CamAud/Arm/README.md

# Arm

Nos rendus de séance se trouvent dans la branche "rapports"
