CamAud/Arm/rapports/séance 8_audrey.pdf

SEANCE 8

Objectif : L'objectif de cette séance était de finaliser la réception de données par Bluetooth et l’écriture réalisée par le robot.

TRAVAIL PRELIMINAIRE : Durant les vacances, j’ai essayé d’avancer au maximum. La tâche principale était de faire en sorte que le bras écrive dans un premier temps la lettre qu’il reçoit via une application Bluetooth.

Etape 1 : Créer mes fonctions de base à partir du code initial. Un travail assez simple finalement. J’ai mis le code initial dans une fonction qui prend en paramètre le point où je veux aller :

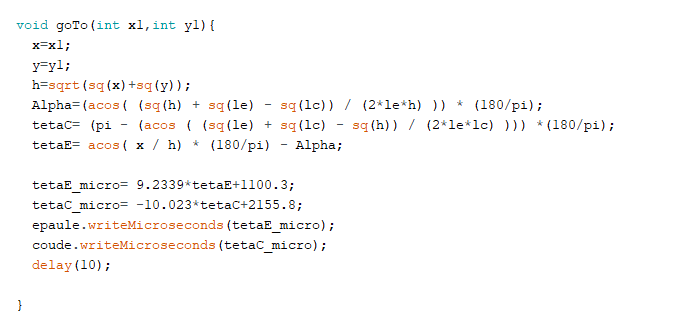
[picture p8: figure]

Pour tracer des traits verticaux et horizontaux, je n’ai donc plus qu’à appeler ces fonctions :

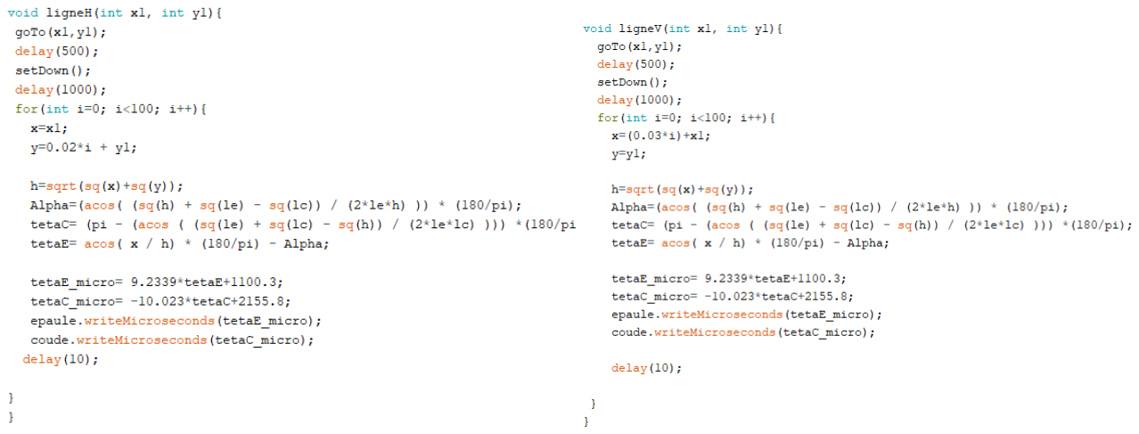
[picture p9: figure]
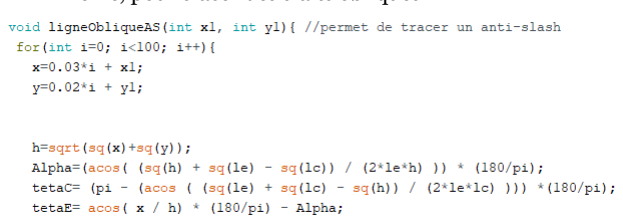
[picture p10: figure]

De même, pour tracer des traits obliques :

JONAS Audrey

Cette fonction me permet de tracer un \ mais lorsque je programme celle qui me permet de tracer un /, le bras ne trace pas du tout un trait droit. Pour cela il vaut donc mieux que j’utilise la fonction goTo.

Etape 2 : Créer une application sur MIT app inventor. Camille avait déjà essayé de créer une application au debut du projet mais elle n’était pas sure de son bon fonctionnement. De plus, elle était en vacances et je n’arrivais pas à me connecter avec son adresse mail pour avoir accès à son projet. Il a donc fallu que je regarde plusieurs tutos pour apprendre à utiliser ce « logiciel ». En m’inspirant de ce qu’elle avait fait, j’ai créé cette application :

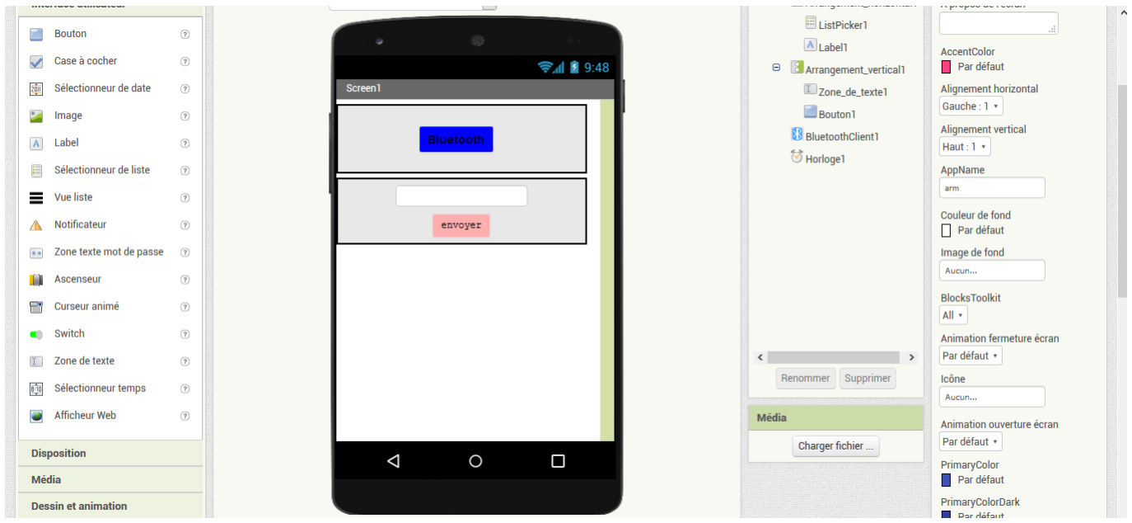
[picture p11: figure]

L’interface se présente comme ceci. Lorsque l’utilisateur appuie sur le bouton bluetooth, il peut choisir notre module bluetooth nommé « arm ». Une fois qu’il clique dessus et que son téléphone se connecte, un message « bluetooth connecté » apparait à l’écran.

Ensuite, il clique sur la barre de saisie, entre la lettre qu’il veut écrire et clique sur le bouton « envoyer ».

Comment l’application fonctionne ? J’ai du définir des « blocs » qui corresponde à différente action à effectuer :

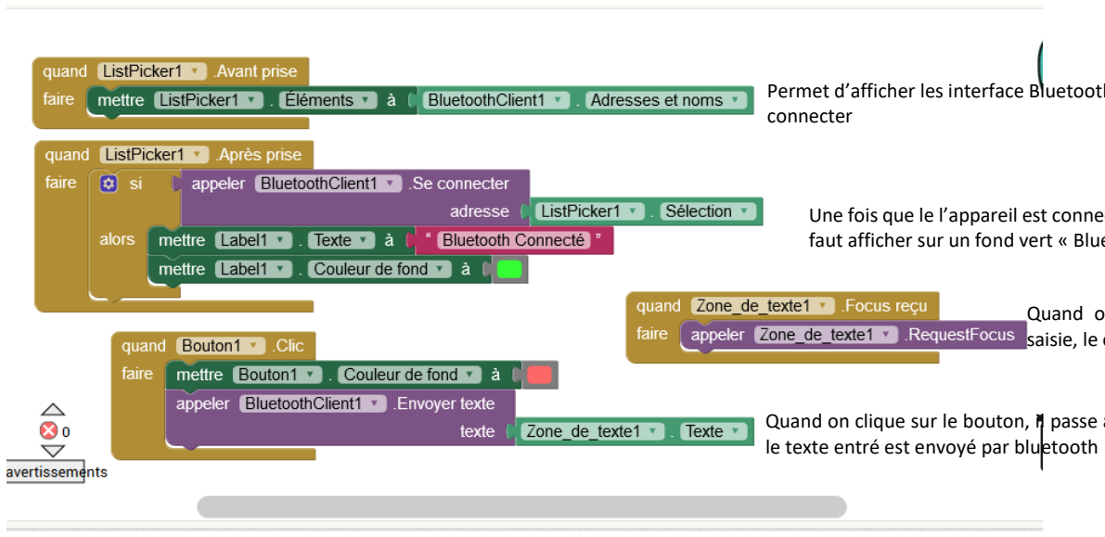
[picture p12: figure]
connecter; le texte entré est envoyé par bluetooth

Etape 3 : Configurer le bluetooth, jusque-là rien de nouveau, il a fallu ajouter :

Permet d’afficher les interface Bluetooth auxquelles on peut se

Une fois que le l’appareil est connecté au bluetooth du bras : il faut afficher sur un fond vert « Bluetooth connecté

Quand on clique sur le bouton, il passe à une couleur plus foncée et

Quand on clique sur la zone de saisie, le clavier apparait

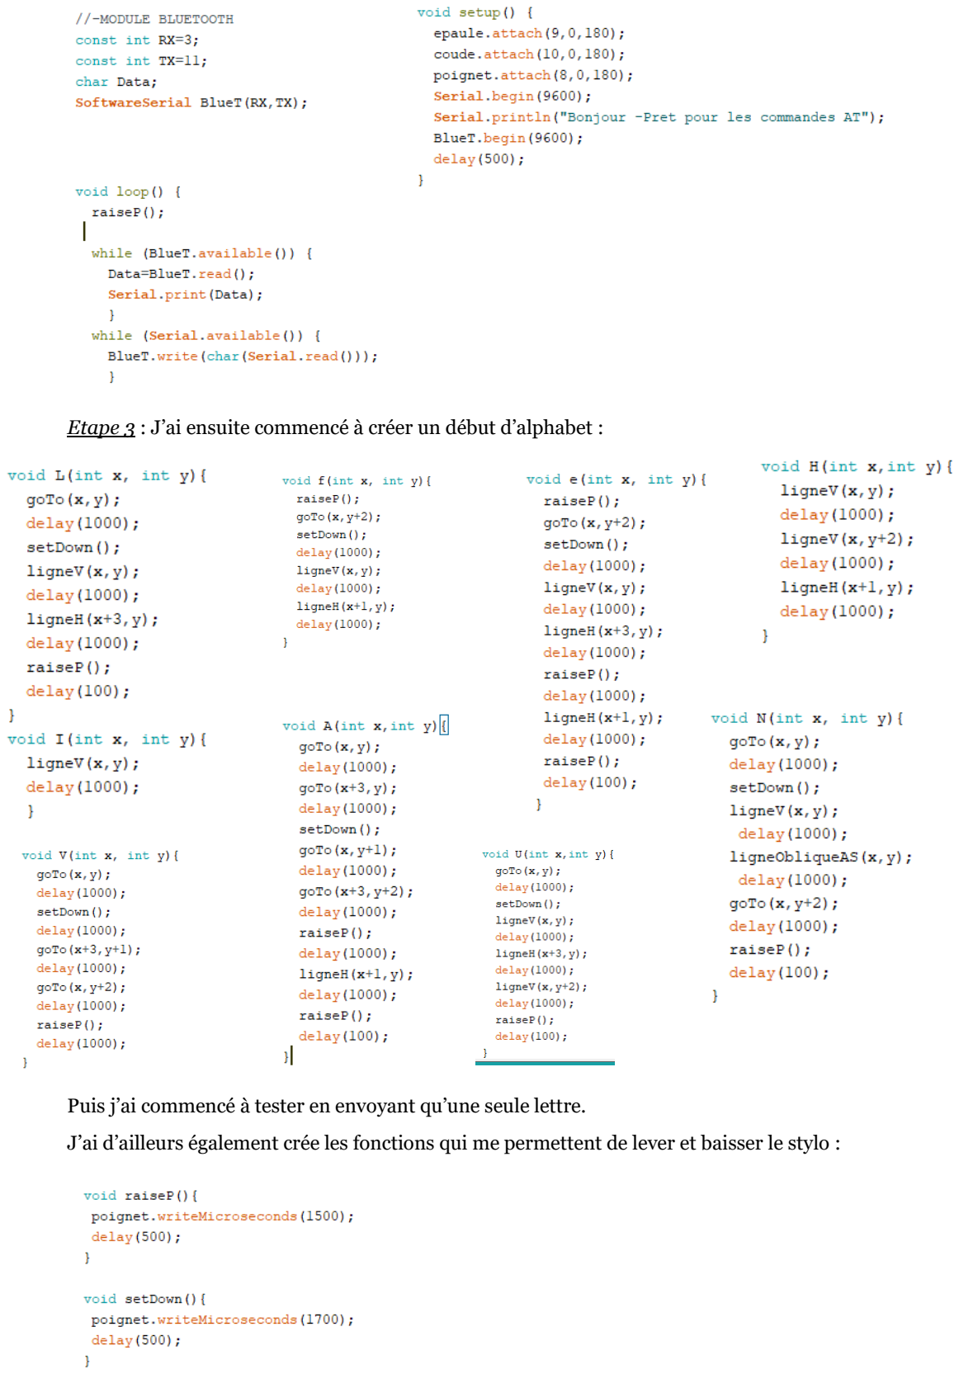
[picture p13: page 3]

Etape 3 : J’ai ensuite commencé à créer un début d’alphabet :

Puis j’ai commencé à tester en envoyant qu’une seule lettre.

J’ai d’ailleurs également crée les fonctions qui me permettent de lever et baisser le stylo :

Problèmes : →je perdais la connexion avec le module Bluetooth alors que je souhaiter envoyer une autre lettre.

→le bras à des problèmes pour se repérer : il va placer un même point à deux endroits proches mais non identiques lorsqu’il doit effectuer plusieurs actions. Lorsque je fais par exemple : ligneH(x,y) puis ligneV(x,y), bien que les paramètres passés aux deux fonctions soient identiques, le bras ne trace pas la ligne vertical pile au debut du trait horizontal. C’est pour cela que pour tracer un E par exemple je ne fais pas : ligneH(x,y) puis ligneV(x,y) mais je le fais aller à (x,y+2) pour ensuite abaisser le stylo et revenir en (x,y) ce qui me permet de tracer le même trait mais en faisant en sorte que les deux lignes se touchent.

SEANCE :

Etape 1 : Durant la première partie de la séance, Camille souhaitait que je lui explique le travail réalisé durant son absence. Je lui ai donc présenté l’ensemble du travail que j’avais réalisé afin qu’elle comprenne le code.

Etape 2 : Ensuite, nous avons réglé le problème de la déconnection du Bluetooth. Vous nous avez rappelé qu’il était nécessaire de placer un condensateur afin d’éviter ce problème. Nous avons d’abord observé comment le bras se comportait lorsqu’il recevait plusieurs lettres à la fois et il semblerait qu’il ne trace que la dernière reçue. Il faut donc pour écrire un mot, envoyer lettre par lettre.

Etape 3 : Il a fallu réfléchir à la manière dont on voulait écrire suite aux différentes contraintes que le bras nous impose. En effet, le bras est censé atteindre tous les points de coordonnées : x appartenant à [-7,+7] et y appartenant à [3, 14]. En réalité le bras lorsqu’il trace atteint les points de coordonnées : x appartenant à [-5,+5] environ et y appartenant à [7, 11] ce qui nous laisse une faible marge de manœuvre sachant que nos lettres sont assez grosses. On a donc choisi d’écrire les lettres les unes sous les autres.

Etape 4 : Définir de nouvelles lettres :

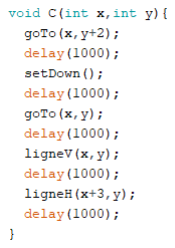
[picture p14: figure]
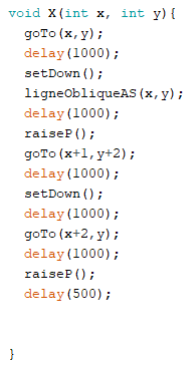
[picture p15: figure]
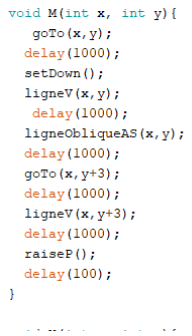
[picture p16: figure]

Etape 5 : Faire en sorte que le stylo se déplace tout seul vers le bas entre chaque lettre : pour cela, on a déclaré des variables x2 et y2 d’abord égale aux coordonnées x,y du point de départ (i.e le point ou le stylo tracera la première lettre).

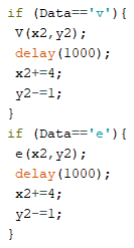
[picture p17: figure]
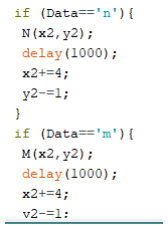
[picture p18: figure]

Puis on fait en sorte que le x s’incrémente de 4 a chaque fois.

Pourquoi décrémenter le y de 1 ? parce que étrangement le stylo se décale vers la droite à chaque fois et n’écrit pas exactement dessous sinon.

Problèmes : | → les traits horizontaux ne sont pas exactement droits
| → Quelques incohérences de placement font que les lettres ne sont pas très belles
| →Le fait de lever le stylo ou le baisser trace des traits que l’on ne souhaite pas.
En effet le stylo est totalement droit lorsque l’on écrit ce qui fait que le soulever un peu trace forcément un trait.
