CamAud/Arm/rapports/seance7_Audrey.pdf

c

a

A b

SEANCE 7

Objectif : L'objectif de cette séance était de comprendre ce travail que vous avez fait et de savoir l’utiliser. Par la suite, il fallait commencer à traiter le module Bluetooth.

TRAVAIL PRELIMINAIRE : Compte rendu du travail que vous avez effectué.

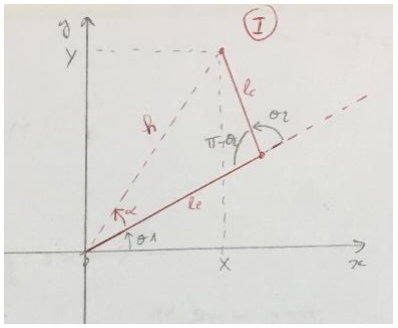
[picture p19: figure]

(1) Pythagore h = √x
2 + y

2

(2) Al Kashi : a

2 = b

2+c

2
-2*b*c*cos(A)

Avec (2) on obtient ℎ

2 = le²+ lc² – 2*lc*le*cos(π-θ2)

### - cos(π-θ2) =

ℎ

2−le²− lc²

– 2∗lc∗le

- θ2 = Tetac= π - cos⁻¹
(

−ℎ

2+le²+ lc²
2∗lc∗le )

Le cercle trigo permet d’écrire :

θ1 = cos⁻¹

(

y
ℎ
) - α | (4)

On obtient α avec (2) :

## lc² = ℎ

## 2 + le² − 2 ∗ ℎ

2

## le² ∗ cos α

## - α = cos⁻¹

(

ℎ

2+le²−lc²
2∗ ℎ²le²
) | (5)

avec (5) et (4) on obtient :

θ1 = Tetae = cos⁻¹

(

y
ℎ

## ) - cos⁻¹ (

ℎ

2+le²−lc²

2∗ ℎ

2

le²

)

JONAS Audrey

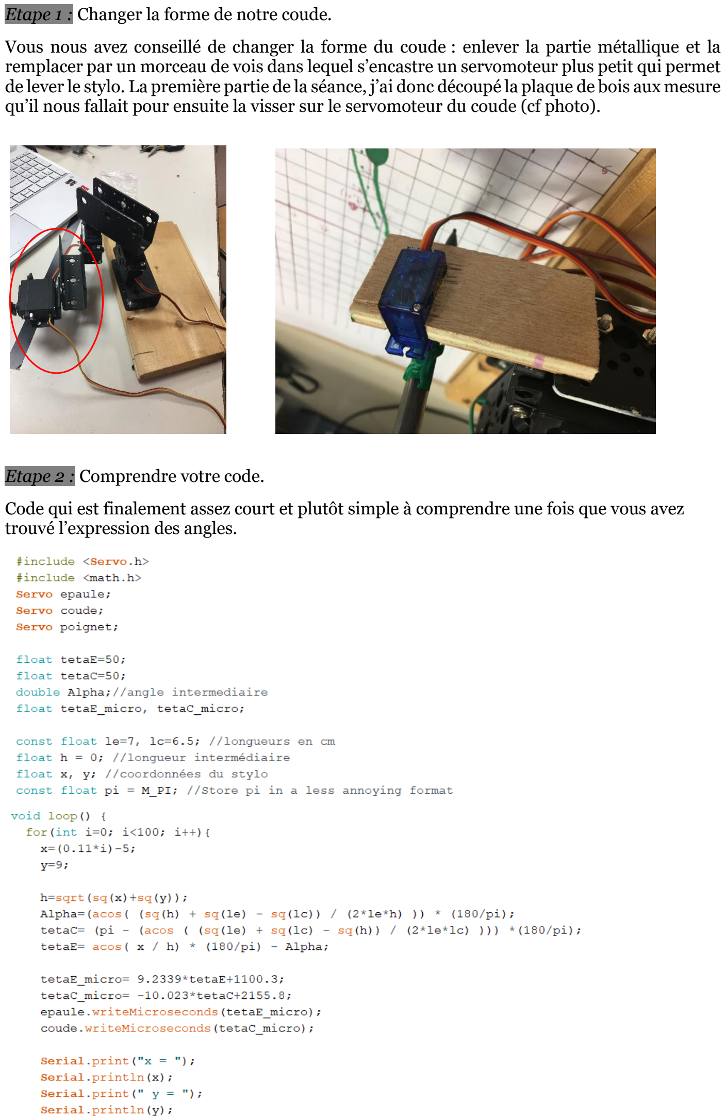
[picture p20: page 2]

Etape 1 : Changer la forme de notre coude.

Vous nous avez conseillé de changer la forme du coude : enlever la partie métallique et la remplacer par un morceau de vois dans lequel s’encastre un servomoteur plus petit qui permet de lever le stylo. La première partie de la séance, j’ai donc découpé la plaque de bois aux mesure qu’il nous fallait pour ensuite la visser sur le servomoteur du coude (cf photo).

Etape 2 : Comprendre votre code.

Code qui est finalement assez court et plutôt simple à comprendre une fois que vous avez trouvé l’expression des angles.

Après modification de la forme du bras, j’ai juste dû changer la longueur lc.

L’exécution entraine bien une droite des points (-5,9) à (5,9), cependant un décalage de quasiment un carreau apparait. Imprécision à traiter.

J’ai par la suite essayé de tracer un trait non plus vertical mais horizontal des points (5,7) à (5,14) (14 étant la distance max atteignable).

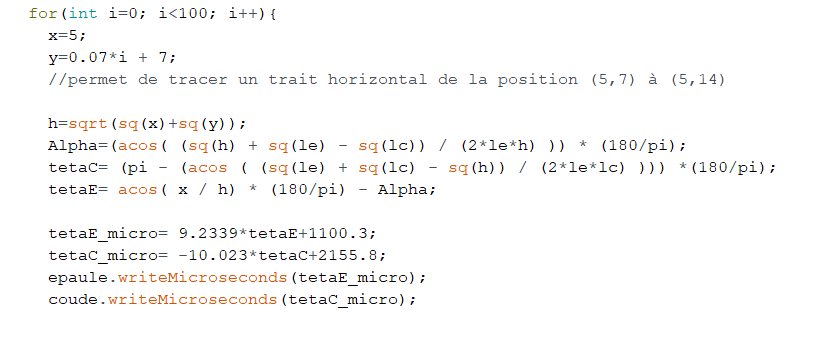
[picture p21: figure]

La ligne est très belle.

Etape 3 : Module Bluetooth.

Nous avons décidé avec Camille de recevoir un mot reçu via une application Bluetooth que le bras devra ensuite écrire.

J’ai donc commencé par brancher le module et vérifier son bon fonctionnement. Pour cela j’ai suivi les étapes de votre cours.

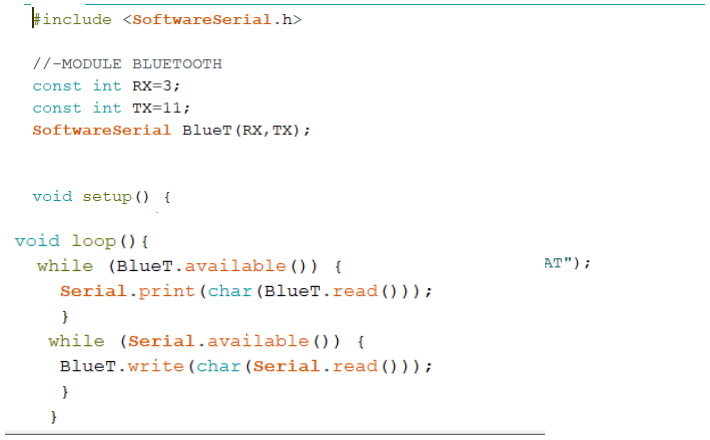
[picture p22: figure]

L’envoie de « AT » m’a bien renvoyé un OK

Après un AT+NAME j’ai pu définir le nom de notre module et j’ai changé le code pin avec AT+PIN. Mon téléphone a bien pu se connecter.

Prochaine objectif des vacances : définir des fonctions qui me permettent de tracer chaque lettre de l’alphabet, toutes de même taille. Ensuite faire en sorte que lorsque le module reçoit une lettre, il sache tracer celle qui correspond. Il va falloir réfléchir à comment faire pour que le bras sache tracer les lettres peu importe sa coordonnée de départ. Pour l’instant, on choisit de quel point à quel point on souhaite tracer notre droite. Il va falloir créer des fonctions générales qui permettent de tracer des traits verticaux/horizontaux de même longueur à partir d’une coordonnée de départ. De plus on souhaite écrire des mots, il va donc falloir faire en sorte que le bras se deplace vers la droite d’une certaine distance à chaque fois qu’il aura fini une lettre. Le plus simple sera de faire en sorte que l’écriture de chaque lettre débute par le haut.
