CamAud/Arm/rapports/README.md

c'est le répertoire avec tous les rapports
