CamAud/Arm/rapports/séance8Camille.odt

PINEAU Camille groupe 2 02/03/2020

SÉANCE 8 : finalisation de notre « Arm Writer »

Présentation du travail effectué :

Dans un premier temps, nous avons décidé de découper cette séance en deux parties.

Tout d’abord, Audrey m’a montrée tout ce qu’elle a pu avancer pendant mon absence.

Ensuite, nous avons continué la programmation de nos lettres et nous avons essayé le module Bluetooth.

Les nouveautés:

En effet, Audrey a fourni un super travail pendant les semaines où je n’ai malheureusement pas pu être présente . Elle m’a alors expliquée ce qui avait changé comme les fonctions concernant les lignes ou encore le servo moteur permettant de tenir le stylo qui est différent de celui d’avant et qui est maintenant fixé sur une planche de bois.

De plus, la carte Arduino est maintenant une carte Uno alors que avant c’était une carte Nano.

Le Bluetooth:

Le Bluetooth que nous possédions auparavant se connecter très mal ce qui ne nous permettait pas d’utiliser l’application pour tracer nos lettres car il se déconnectait spontanément. Monsieur Masson nous a alors fourni un second module Bluetooth qui marchait mieux mais il se déconnectait encore souvent…

Alors, Monsieur Masson nous a proposé de fixer un condensateur pour gérer les problèmes de connexion.

En effet, c’était la bonne solution car maintenant cela fonctionne.

La programmation des lettres :

D’une part, j’ai continué a programmer les lettres comme la lettre X .

La programmation est plutôt simple une fois que toutes les fonctions appelées sont finis.

Cependant, il faut resté minutieux concernant la position du stylo ; c’est-à dire savoir s’il faut le lever ou le baisser pour qu’il puisse écrire sans faire de traits inutiles.

void X(int x, int y){

goTo(x,y);

delay(1000);

setDown();

ligneObliqueAS(x,y);

delay(1000);

raiseP();

goTo(x+1,y+2);

delay(1000);

setDown();

delay(1000);

goTo(x+2,y);

delay(1000);

raiseP();

delay(500);

}

Voici un exemple de code d’une lettre (ici la lettre X).

Aussi, il faut faire attention aux coordonnés de notre axe.

En effet, nous avons remarqué que l’on ne peut plus contrôler notre bras au-delà de -5 sur l’axe des ordonnées et de 8 sur l’axe des abscisses .

C’est pour cela, que nous avons initialisé les constantes x2 et y2 comme ci dessous :

int x2=-5;

int y2=8 ;

D’autre part, une fois un bon nombre de lettre programmé, on souhaitait écrire deux lettres l’une après l’autre après les avoir tapées sur notre application MIT.

Cependant, nous nous sommes rendus compte que lorsque que l’on rentrait EV sur notre application par exemple ; notre bras écrivait seulement le V .

Mais, lorsque l’on tapait E puis V notre bras écrivait bien ces lettres dans cet ordre.

Puis, on a décidé d’écrire nos lettres les unes dessous les autres car cela nous laissé une meilleure amplitude pour écrire des petits mots.

Hors, après plusieurs tests nous avons réussi à les écrire comme on le souhaitait.

Il fallait dans la boucle rajouter à chaque lettre une augmentation de 4 pour le x et une diminution de 1 pour le y (car sans explication il se déplaçait progressivement vers le droite à chaque lettre).

if (Data=='x'){

X(x2,y2);

delay(1000);

x2+=4;

y2-=1;

}

Le projet:

Enfin, nous avons clôturé la séance en discutant sur notre présentation et sur notre projet réalisé.

Je suis très déçue d’avoir manqué certaines séances et je vous présente toutes mes excuses pour ces absences .

Je devrai normalement être présente pour l’oral la semaine prochaine.
