CamAud/Arm/rapports/seance5_Audrey.pdf

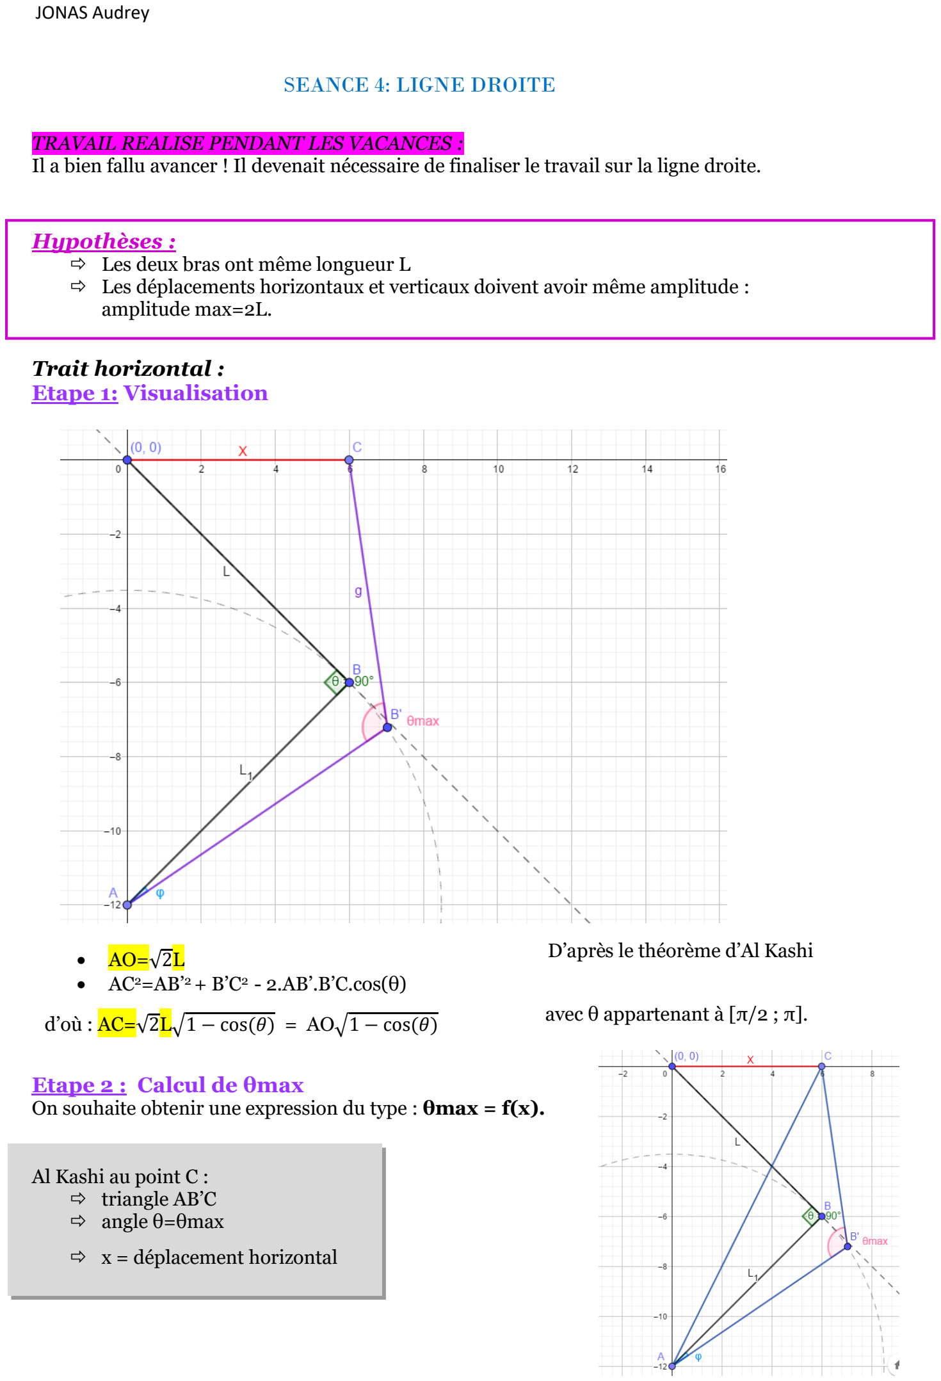
[picture p51: page 1]

SEANCE 4: LIGNE DROITE

TRAVAIL REALISE PENDANT LES VACANCES :
Il a bien fallu avancer ! Il devenait nécessaire de finaliser le travail sur la ligne droite.

Hypothèses :
- Les deux bras ont même longueur L
- Les déplacements horizontaux et verticaux doivent avoir même amplitude : amplitude max=2L.

Trait horizontal :
Etape 1: Visualisation

Etape 2 : Calcul de θmax
On souhaite obtenir une expression du type : θmax = f(x).

Al Kashi au point C :
- triangle AB’C
- angle θ=θmax
- x = déplacement horizontal

JONAS Audrey

- AO=√2L
- AC²=AB’² + B’C² - 2.AB’.B’C.cos(θ)

d’où : AC=√2L√1 − cos(θ) = AO√1 − cos(θ)

D’après le théorème d’Al Kashi

avec θ appartenant à [π/2 ; π].

AC² = AB’² + B’C² – 2.L²

.cos(θmax)

- AC² = L² + L² – 2.L²
.cos(θmax)
- AC² = 2 . L² (1 – cos(θmax))

AC²

= OA² + OC²

- AC² = 2L² + x²
- AC= √2L
2 + x

2

(1) (2)
(1) , (2) → (3)

2.L2 + x2 = 2.L2 – 2.L2 cos(θmax)

- x2 = -2.L2.cos(θmax)
- x = √2.L. √−cos(θmax)
- Cos (θmax) = -

x

2
2.L

2

Finalement :

θmax = cos⁻¹

(−

x

2
2.L

2

)

Le résultat paraît cohérent, lorsque x augmente l’angle augmente.

Etape 3 : Calcul du second angle
On cherche à exprimer l’angle ϕ , angle de rotation autour du point A

Expression de l’angle à appliquer au coude pour effectuer une distance x : θmax - π/2

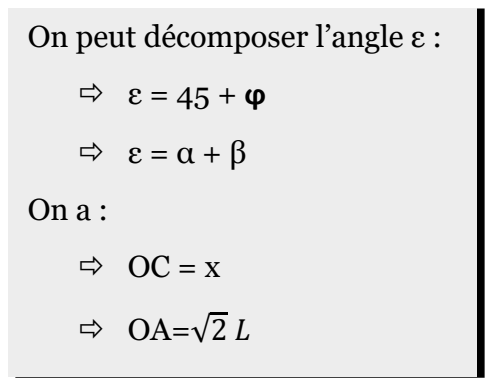
[picture p52: figure]
On peut décomposer l’angle ε :
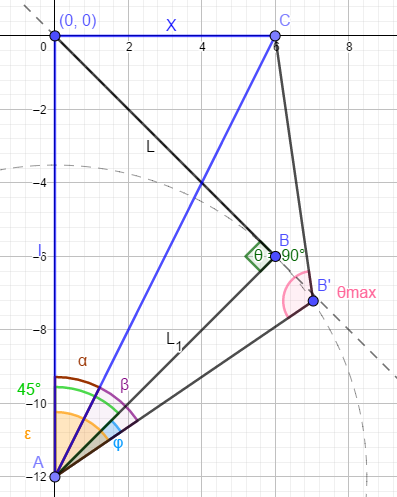
[picture p53: figure]

→Calcul de α :
Th. Al Kashi dans le triangle AOC :

OC² = OA² + AC² – 2.OA.AC.cos(α)

- x

2 = 2L² + 2L² + x² – 2(√2L . √2L 2 + x

2 ) cos(α)

- 4L² = 2√2L √2L
2 + x

2 cos(α)

- cos(α)= √2L
√2L
2+x

2

- α=cos⁻¹

(

√2L
√2L
2+x

2

) (1)

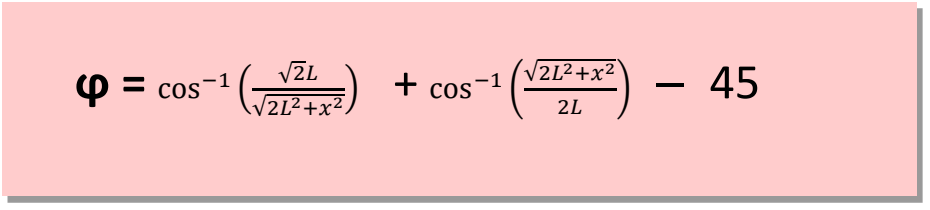
[picture p54: figure]
ϕ = cos⁻¹; ) + cos⁻¹ ( √2L 2+x

Trait horizontal :
Etape 1: Visualisation

→Calcul de β :
Th. Al Kashi dans le triangle ACB’ :

B’C² = AB’² + AC² – 2.AB’.AC.cos(β )

- L² = L² + (2L² + x²⁾ – 2L(√2L
2 + x

2 ) cos(β)

- cos(β)=√2L
2+x

2
2L
- β =cos⁻¹ (
√2L
2+x

2
2L

) (2)

→Calcul de ϕ :

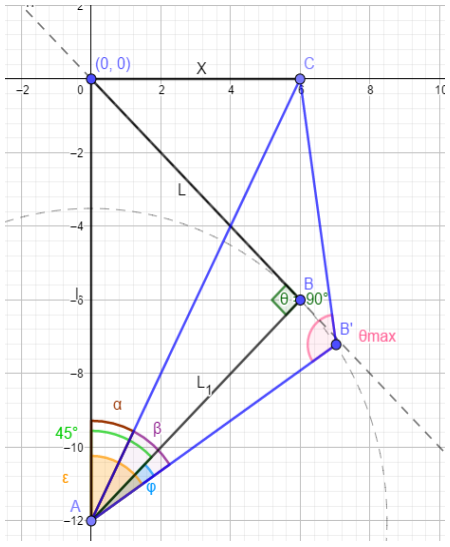
[picture p55: figure]

On peut désormais conclure sachant que : ϕ = α + β – 45 (3)

(1) , (2) → (3)

Expression de l’angle à appliquer à l’épaule pour effectuer une distance x.

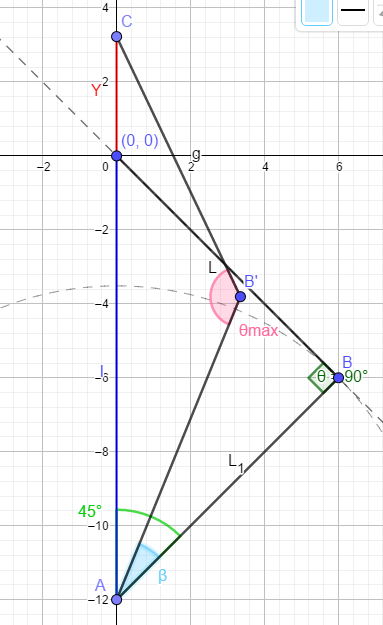
[picture p56: figure]

Conditions initiales :
- θ0 =π/2
- θmax=π
- AO=√2L
- AC=√2L+ y

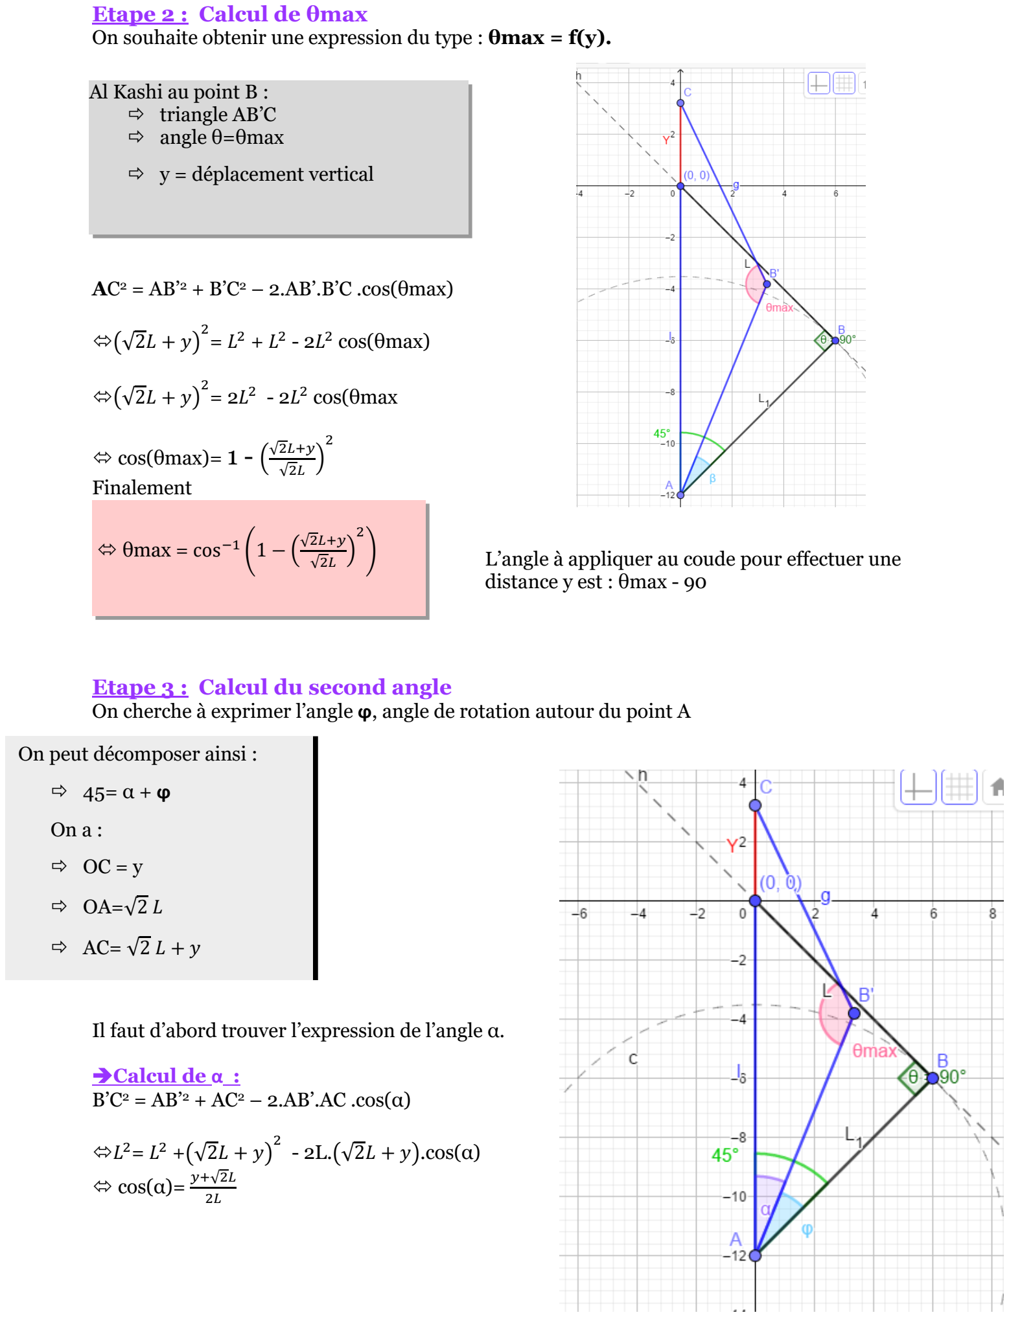
[picture p57: page 4]

Al Kashi au point B :
- triangle AB’C
- angle θ=θmax
- y = déplacement vertical

Etape 2 : Calcul de θmax
On souhaite obtenir une expression du type : θmax = f(y).

AC² = AB’² + B’C² – 2.AB’.B’C .cos(θmax)

(√2L + y)

2
= L

2 + L

2
- 2L

2
cos(θmax)

(√2L + y)

2
= 2L

2
- 2L

2
cos(θmax
- cos(θmax)= 1 - (

√2L+y
√2L

)

2

Finalement

- θmax = cos⁻¹ (1 − (
√2L+y
√2L

)

2
)

Etape 3 : Calcul du second angle
On cherche à exprimer l’angle ϕ, angle de rotation autour du point A

Il faut d’abord trouver l’expression de l’angle α.

→Calcul de α :
B’C² = AB’² + AC² – 2.AB’.AC .cos(α)

L

2= L

2 +(√2L + y)

2
- 2L.(√2L + y).cos(α)
- cos(α)= y+√2L
2L

L’angle à appliquer au coude pour effectuer une distance y est : θmax - 90

On peut décomposer ainsi :

- 45= α + ϕ

On a :

- OC = y
- OA=√2 L
- AC= √2 L + y

α = cos⁻¹

(

y+√2L
2L

)

→Calcul de ϕ :
On peut désormais conclure sachant que : 45= ϕ + α

Objectif : L'objectif de cette séance était d’essayer de mettre en pratique la théorie.

J’ai d’abord dû créer un programme me permettant de mettre l’épaule et le bras dans la situation initiale cad perpendiculaires l’un à l’autre et l’épaule formant un angle de 45° par rapport à l’axe Y. J’ai rencontré un premier problème car je sais que les deux bras sont alignés lorsque le coude est à 155°. Je m’attendais donc à les avoir perpendiculaires lorsque je le mets à 65. Et bien non, après différents essais je me suis rendue compte qu’il fallait que je lui applique un angle de 35°.

Vous nous avez conseillé d’appliquer les angles plutôt en Millisecondes pour plus de précision.

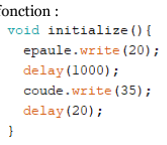
[picture p58: figure]

J’ai donc crée ma fonction :

J’ai ensuite commencé l’écriture de la fonction qui me permet de tracer une ligne droite horizontale.

Expression de l’angle à appliquer à l’épaule pour effectuer une distance verticale y.

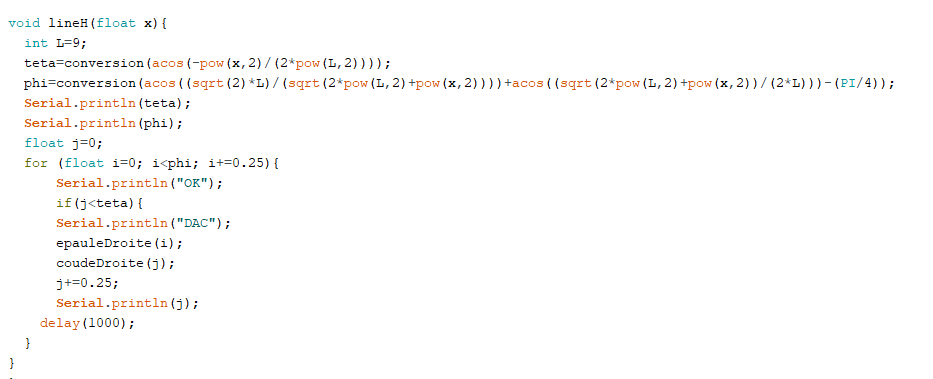
[picture p59: figure]

La fonction arccosinus de arduino renvoie des angles en radians, j’ai donc écrit une fonction « conversion » qui me permet de les convertir en degré.

Mais j’avais un problème car sur le moniteur série, l’affichage du calcul de l’angle de l’épaule était « nan » soit Not A Number. Après recherche, je me suis rendue compte que c’était parce que dans mon calcul je n’avais pas converti les 45°en radian ! Dans la formule je ne dois pas soustraire 45 mais π/4. Le résultat n’était donc pas dans le domaine de définition de la fonction.

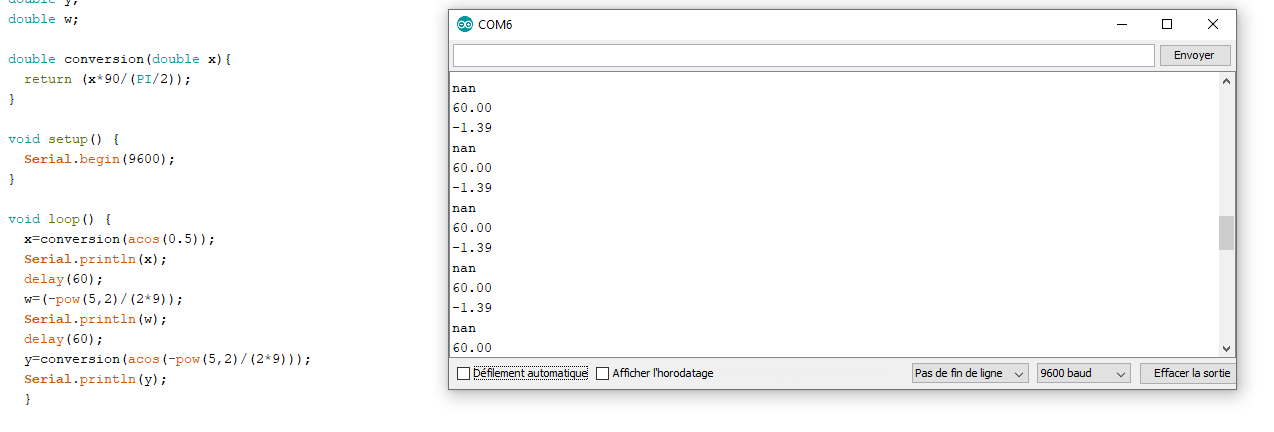
[picture p60: figure]

L’affichage du OK et du DAC me permet de vérifier que j’entre bien dans la boucle.

Une fois avoir tout réglé le programme s’exécute en entier.

Le seul problème est que, pour une distance test de 5, l’angle à appliquer à l’épaule est plus grand que l’angle max qu’il peut effectuer vers la droite.

Problème à régler la prochaine fois, à voir si on ne définit pas une taille max (ou standard) de trait à réaliser dans un premier temps.
